printedcircuitbeans/RP2040-SM-PCB/CAD FILES/readme.txt

CAD FILES for the RP2040 based smartwatch:
