printedcircuitbeans/RP2040-SM-PCB/Alitum Exports/FAB-RP2040 DEV SW FINAL-A.2/Report Board Stack/DEV-NEAT-FINAL.xls

Board Stack Report
Stack Up |  | Layer Stack
Layer | Board Layer Stack | Name | Material | Thickness | Constant
1 |  | Top Paste
2 |  | Top Overlay
3 |  | Top Solder | Solder Resist | 0.40mil | 3.5
4 |  | Top Layer | Copper | 1.38mil
5 |  | Dielectric 3 | 7628*1 | 8.28mil | 4.1
6 |  | Layer 2 | Copper | 0.60mil
7 |  | Dielectric 4 | Core-009 | 41.93mil | 4.5
8 |  | Layer 1 | Copper | 0.60mil
9 |  | Dielectric 1 | 7628*1 | 8.28mil | 4.8
10 |  | Bottom Layer | Copper | 1.38mil
11 |  | Bottom Solder | Solder Resist | 0.40mil | 3.5
12 |  | Bottom Overlay
13 |  | Bottom Paste
 | Height : 63.25mil
