printedcircuitbeans/RP2040-SM-PCB/DATASHEETS/H424a9c0b000a45a7a4c9680e89fcf62a3.webp

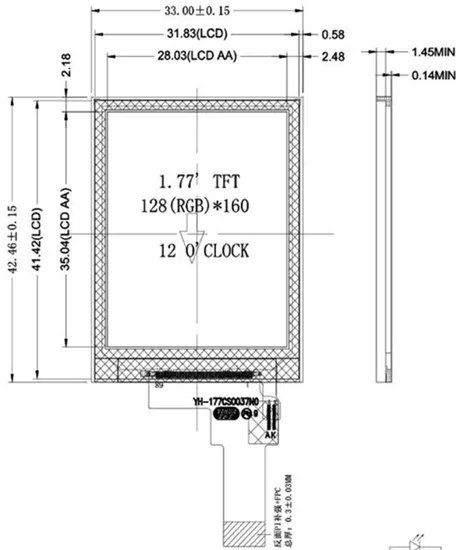
DATASHEETS/H424a9c0b000a45a7a4c9680e89fcf62a3.webp
