printedcircuitbeans/RP2040-SM-PCB/Alitum Exports/PCBA-RP2040 DEV SW FINAL-[NO VARIATIONS]-A.2/BOM/BOM_PartType-RP2040 DEV SW FINAL.xlsx

Comment | Description | Designator | Footprint | LibRef | Quantity
Renesas DA14531-00000FX2 | Bluetooth 5.1 SoC ARM Cortex-M0+ 16MHz Single Core 1.1V to 3.3V SMD 148-Pin HVQFN | *1 | Renesas DA14531-00000FX2-Footprint-1 | CMP-129872772-4 | 1
Maxim Integrated MAX30100EFD+T | Pulse Oximeter and Heart-Rate Sensor IC 14-Pin OLGA T/R | *2 | Maxim Integrated MAX30100EFD+T-Footprint-1 | CMP-50cf9b13ca238f08-2 | 1
STMicroelectronics IIS2MDCTR | IIS2MDC Series 3.6 V Ultra-Low-Power 3-axis Digital Magnetic Sensor - LGA-12 | *3 | LGA-12 2.0 x 2.0 x 0.7 mm | CMP-a578694f2da77abf-3 | 1
InvenSense MPU-6050A | Analog Circuit, 1 Func, CMOS | *4 | PCB-1172158-1 | CMP-a17e6d5fd3637eb9-1 | 1
Samsung CL05B104KP5NNNC | CL05 Series 0.1 uF 10 V ±10 % Tolerance X7R SMT Multilayer Ceramic Capacitor | C1, C2, C3, C4, C5, C6, C7, C8, C9, C11, C12, C20, C28, C29 | PCB-wdo14ufqtx9e5lciolxc-1 | CMP-97145e617dc648d3-3 | 14
Samsung CL05A105KO5NNNC | CL05 Series 1 uF 16 V ±10 % Tolerance X5R SMT Multilayer Ceramic Capacitor | C10, C13, C18, C19, C24, C26, C27, C31, C32, C35, C36, C40 | Samsung CL05A105KO5NNNC-Footprint-1 | CMP-a18e680969d57e49-13 | 12
Murata GJM1555C1H150FB01D | Cap, 15p, C0G, 1%, 50V, 0402 | C14, C15 | PCB-4vt9n1dcietv35vzc4o1-1 | CMP-3570434-3 | 2
Murata GJM1555C1H1R8WB01D | Multilayer Ceramic Capacitors MLCC - SMD/SMT 0402 1.8pF 50Volts C0G +/-0.05pF | C16, C17 | CAPC1005X55X25LL05T10 | CMP-3552358-2 | 2
TDK C1608X5R1C475K080AC | Eia Case Size: 0603, Voltage: 16, Cap Value: 4700000, Tol: +/-10%, Thickness: 0.80 ± 0.10 | C21, C22, C23, C37 | 1608(0603) IPC CAP | CMP-77fabf7cbdb2a83d-7 | 4
Samsung CL10A106MQ8NNNC | Ceramic capacitor SMD-0603 10uF /6.3V X5R# M +-20%, Samsung, RoHS | C25 | PCB-2sbl9jnrnicgpdohsx1t-1 | CMP-093fc04ae399d6f8-2 | 1
AVX Interconnect / Elco 0603ZC224JAT2A | CAP CER 0.22UF 10V 5% X7R 0603 | C30 | CAPC1608X90X35NL15T15 | CMP-130958-3 | 1
Vitramon VJ0603Y103KXAPW1BC | Multilayer Ceramic Capacitors MLCC - SMD/SMT 0603 0.01uF 50volts X7R 10% | C33 | CAPC1608X95X40NL15T15 | CMP-3553671-2 | 1
Murata GRM1885C1H222JA01D | 0603 2.2 nF 50 V ±5% Tolerance C0G SMT Multilayer Ceramic Capacitor | C34 | PCB-8dymt4l4b369ba09ow0n-1 | CMP-dffd16f504ca003a-2 | 1
AVX 06036D106MAT2A | 0603 10 uF 6.3 V ±20 % Tolerance X5R Surface Mount Multilayer Ceramic Capacitor | C38 | CAPC1608X90X35LL15T15 | CMP-127006-7 | 1
0.01 uF 0402 X7R capacitor | 0.01 uF 0402 X7R capacitor | C39 | CAPC1005X55X25LL05T05 | CMP-3553635-7 | 1
Molex 73412-0114 | RF / Coaxial Connector, Coaxial, Straight Jack, Surface Mount Vertical, 50 ohm, Brass | CON1, CON2 | PCB-6g8ee53o8kk4vespa54x-1 | CMP-db4512efd04e0482-2 | 2
Vishay VLMG1500-GS08 | LED Uni-Color Yellow Green 574nm 2-Pin Chip 0402(1006Metric) T/R | D1 | PCB-w8p5vpt5ck0v4tv1c0z3-1 | CMP-709bb8fee08eaf5c-2 | 1
TE Connectivity CRGP0603F10K | Res Pulse Withstand Thick Film 0603 10k Ohm 1% 1/4W ±100ppm/°C Molded Paper T/R | DNF1 | RESC1609X50X30ML10T20 | CMP-518d9deba10a8e4a-1 | 1
Texas Instruments BQ29707DSET | Li-Ion/Li Polymer Advanced Single-Cell Battery Protector IC Family 6-WSON -40 to 85 | IC1 | PCB-g2sx667f610inbgayesa-1 | CMP-4d0d86cbeaee92ca-1 | 1
Würth Elektronik 693072010801 | WR-CRD Micro SD Card Connector, Hinge Type | J1 | PCB-do3jp31eh8pi4jp1qrj0-1 | CMP-fef136a731692136-4 | 1
Würth Elektronik 68712414522 | FFC / FPC Board Connector, Right Angle, Surface Mount, Receptacle, 24, Top, 0.5 mm | J2 | PCB-a5ulz59vuszfit0rje83-1 | CMP-d08318d21a710f44-6 | 1
Global Connector Technology USB4105-GF-A Reversible | Conn USB 2.0 Type C RCP 16 POS 0.3mm/0.5mm Solder RA SMD 16 Terminal 1 Port T/R | J3 | PCB-jtoj50qxusyca8vax1pa-1 | CMP-02a6cdcbf5c5dd61-16 | 1
Murata LQP03TN3N3B02 | Fixed Ind 3.3NH 450MA 250 Mohm | L1 | CAPC0603X33X15NL03T05 | CMP-68076667-1 | 1
Murata LQG15HN27NJ02D | Inductor RF Chip Unshielded Multi-Layer 27nH 5% 100MHz 8Q-Factor Ceramic 300mA 670mOhm DCR 0402 T/R | L2 | PCB-rkasoom3n033do6ysrzd-1 | CMP-af81668e63ad7046-2 | 1
Taiwan Semiconductor TSM320N03CX RFG | Trans Mosfet N-ch 30V 4A 3-PIN SOT-23 T/r | Q1 | PCB-o1p2u0wd1kv0akxl2dnz-1 | CMP-f47a39300fc92bbd-1 | 1
Diodes Inc. DMS2085LSD-13 | Trans MOSFET P-CH 20V 3.3A Automotive 8-Pin SO T/R | Q2 | PCB-u540y1ba36l7q4ljo86i-1 | CMP-469b8d639ac3995c-1 | 1
CSD16406Q3 | the nexfet power mosfet has been designed to minimize losses in power conversion applications. | Q3, Q4 | PCB-fjclzc86ay25m1aekmjs-1 | CMP-4f7f86ea0b4d90b8-3 | 2
Vishay Dale TNPW04021K00BEED | Thin Film Resistors - SMD 1Kohms .1% 25ppm | R1, R2, R19 | RESC1005X40X20NL05T10 | CMP-1862936-2 | 3
Panasonic ERJ-2RKF1004X | Res Thick Film 0402 1M Ohm 1% 1/10W ±100ppm/°C Molded SMD Punched Carrier T/R | R3, R4 | Panasonic ERJ-2RKF1004X-Footprint-1 | CMP-3655675-6 | 2
Panasonic / Panasonic ECG ERJ-2RKF1003X | Resistor Thick Film 0402 100k Ohm 1% 1-10 Watt ±100ppm °C Surface Mount Punched Carrier Tape and Reel | R5, R6, R7, R8, R9, R12, R13, R17, R20 | PCB-8tuutlkq7p1aj3t2dfdp-1 | CMP-3656264-9 | 9
Panasonic ERJPA3F22R0V | PANASONIC ERJPA3F22R0V RESISTOR, ERJP, 22 OHM, 0603, 0.25W, 1% | R10 | PCB-12519960-1 | CMP-12519960-2 | 1
Yageo RC0402FR-0710KP | Res Thick Film 0402 10K Ohm 1% 0.063W(1/16W) ?150ppm/C Epoxy SMD T/R | R11, R23 | PCB-ailbuo3ywjkw9fqo6ae9-1 | CMP-ab0360df1e7174c4-1 | 2
Panasonic ERA-3AEB331V | Res Thin Film 0603 330 Ohm 0.1% 1/10W ±25ppm/°C Molded SMD SMD Punched Carrier T/R | R14 | PCB-8r88lubijgs0c6mgtabl-1 | CMP-4ace83d64f829509-1 | 1
Yageo AC0402FR-075K1L | 0402 5.1k ohms 1% automotive grade chip resistor | R15, R18 | RESC1005X37X25NL05T10 | CMP-9589553-2 | 2
Ohmite HVC0603T5004FET | Res, Thick Film, 5m, 1%, 0.1w, 0603, Reel | R16, R22 | CAPC1608X90X35ML10T15 | CMP-d904124280fd06c3-2 | 2
CRGCQ0603J2K2 | Res, AEC-Q200, Thick Film, 2K2, 5%, 0603 | R21 | PCB-2t5lv6a742zfbi3344hk-1 | CMP-ce770211389311b0-1 | 1
Yageo / Phycomp RC0402FR-0727R4L | Thick Film Resistors 27.4 OHM 1% | R24, R25 | RESC1005X40X25ML05T10 | CMP-3759239-2 | 2
TE Connectivity CRGCQ0402J4K7 | Res, Aec-Q200, Thick Film, 4K7, 5%, 0402 | R26, R27, R28 | PCB-14dubun49lr56ezfiiqx-1 | CMP-86884aee70c6594f-2 | 3
CRGP0603F10R | Res Thick Film 0603 10 Ohm 1% 0.25W(1/4W) ±100ppm/°C Pad SMD Automotive T/R | R29 | R0603_A | CMP-9edf52b96e5b4118-1 | 1
Würth Elektronik 436331045822 | SWITCH, 220GF, SIDE, BLK, SMD, BOSS; Contact Configuration: DPST; Operating Force: 220N; Contact Voltage DC Nom: 12V;... | S1, S2, S3, S4, S5 | PCB-9flvzoe0mjj29e3x6sbq-1 | CMP-c24e0a183ce31d89-1 | 5
Panasonic ERTJ1VG103FA | Thermistor NTC 10K Ohm 1% 2-Pin 0603 Surface Mount Solder Pad 3435K Paper T/R | T1 | RESC1608X90X30ML15T20 | CMP-2b8ee208eb7af449-1 | 1
Winbond W25Q16JVUXIQ | 16Mb Serial NOR Flash 133MHz USON8 | U1 | Winbond W25Q16JVUXIM TR-Footprint-1 | CMP-467c8a66a27f99bb-1 | 1
u-blox MAX-M10S-00B | MAX-M10 Series 3.6 V 167 dBm Surface Mount Standard Precision GNSS Module | U2 | PCB-005urkm0n3ublf78fa9k-1 | CMP-560f9853949789c8-2 | 1
RP2040 | Raspberry Pi , Mcu, 32 Bit, 133MHZ, QFN-56; | U3 | RP2040-Footprint-1 | CMP-0073ce6d2ab8dfb4-11 | 1
TC1185-3.3VCT713 | 50 mA, 100 mA and 150 mA CMOS LDOs with Active-Low Shutdown and Reference Bypass, 5-Pin SOT-23, Extended Temperature, Tape and Reel | U4, U8 | SOT-23-CT5_N | CMP-1493173-2 | 2
MCP73837-FCI/MF | Stand-Alone Li-Ion/Li-Polymer Battery Charge Management Controller with Autonomous AC-Adapter or USB-Port Source Selection, 4.2V, 10-Pin DFN, Industrial Temperature | U5 | DFN-MF10 | CMP-961403-2 | 1
Bosch Tools BME680 | BME680 Series 3.6 V 3.1 µA Low Power Gas Pressure Temperature humidity Sensor | U6 | PCB-909kwbqua9921xjxq73y-1 | CMP-8bd947d89053541e-2 | 1
LD39015M18R | 150 mA Low Quiescent Current Low Noise Voltage Regulator, 1.8V, 5-Pin SOT-23, Tape and Reel | U7 | SOT23-5L_N | CMP-1494047-2 | 1
Abracon ABM3C-12.000MHZ-D4Y-T | Crystal 12MHz Â±30ppm (Tol) Â±30ppm (Stability) 18pF FUND 60Ohm Automotive 4-Pin CSMD T/R | X1 | PCB-uqcmlcvakm867rdp8al8-1 | CMP-55e09ddaa6fe8a27-2 | 1
Murata XRCGB32M000F1H00R0 | Crystal 32.0000mhz 6pf Smd | X2 | PCB-j1edtquohpspoyruottx-1 | CMP-7e03b3e81033a1c4-2 | 1
