printedcircuitbeans/RP2040-SM-PCB/DOCUMENTATION/Main Schematic B&W.pdf

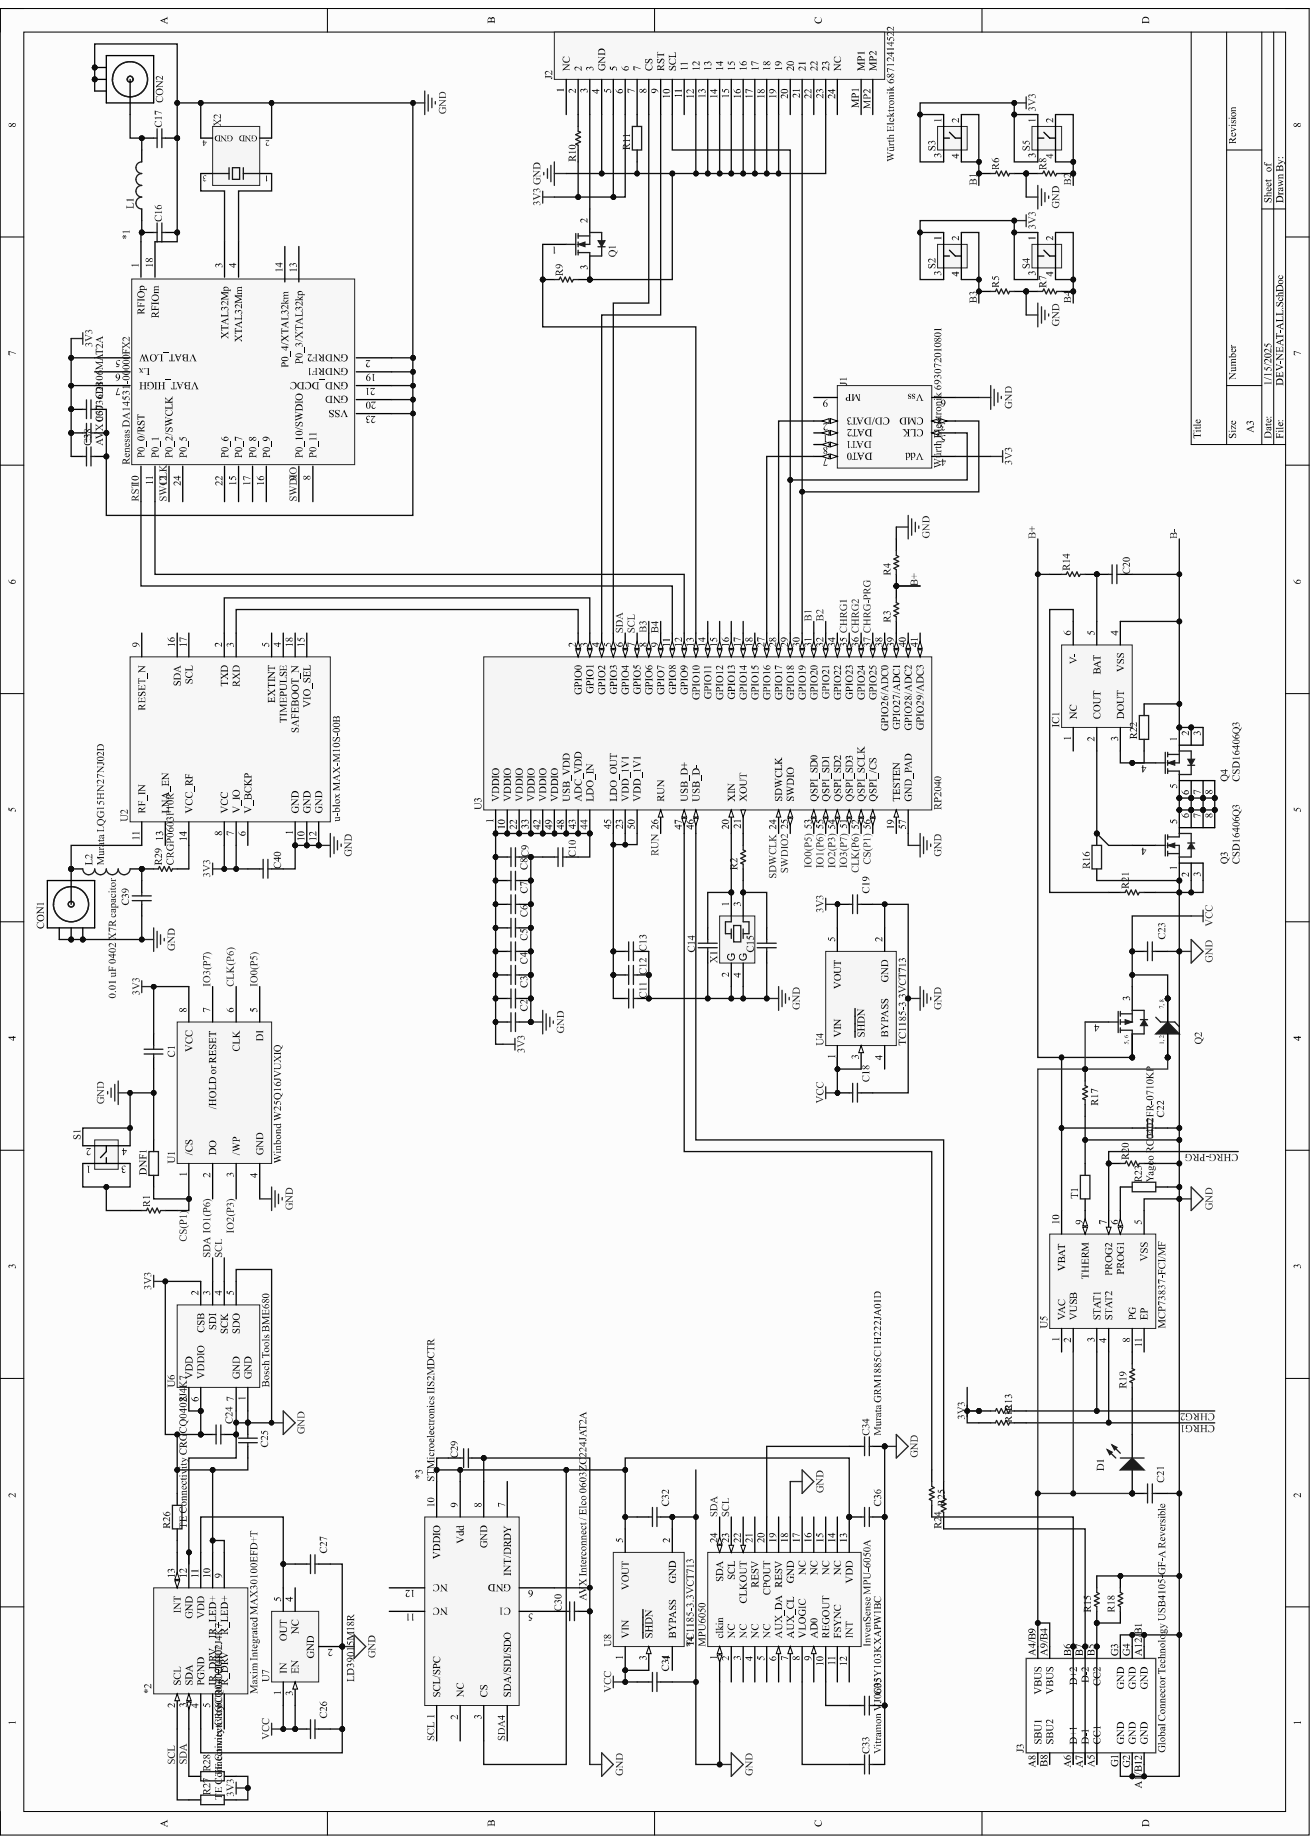
[picture p2: page 1]
