printedcircuitbeans/RP2040-SM-PCB/Alitum Exports/FAB-RP2040 DEV SW FINAL-A.2/Fabrication.PDF

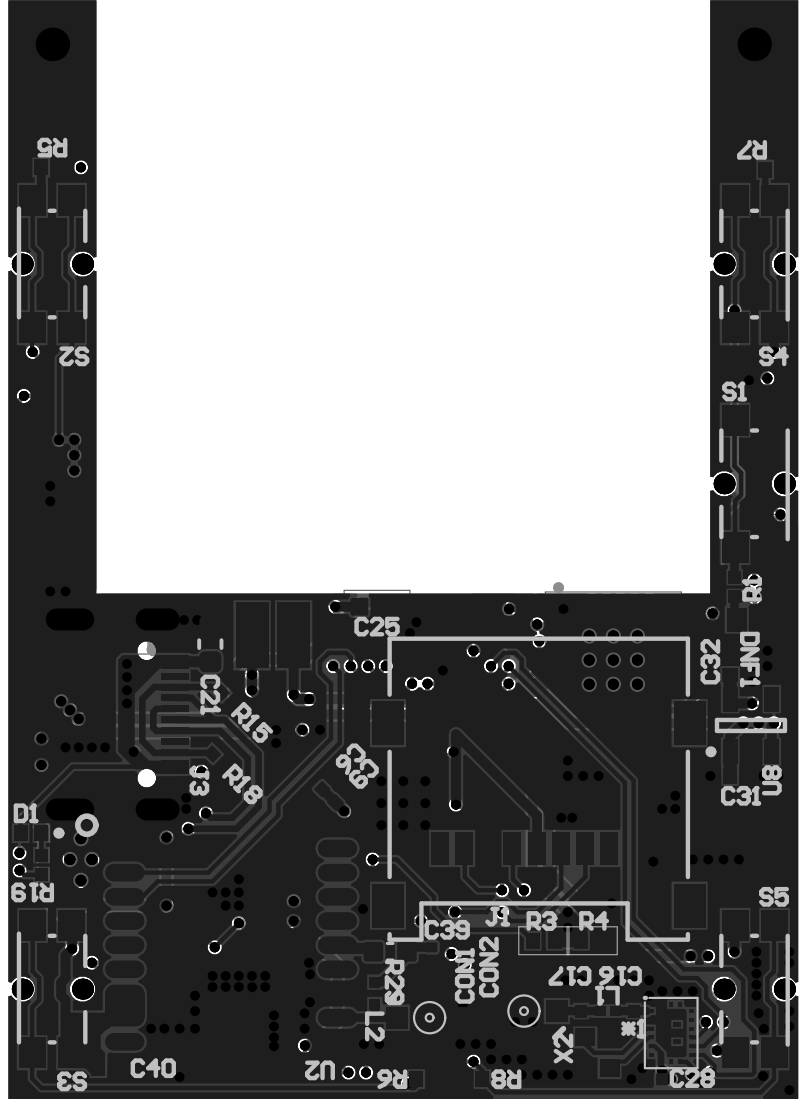
[picture p3: page 1]
