printedcircuitbeans/RP2040-SM-PCB/(commit log)

2024-12-01 Create Board changelog
2024-12-01 Update Board changelog
2025-01-15 Added updated BOM with all correct part numbers
    [20250115_rp2040_dev_sw_final_xlsx.csv]
2025-02-14 Update WATCHBasic01.ino
    -Added a proper on / off system using button delays
    -Started framework for MAX30100
    -Some UI framework
2025-02-26 Update WATCHBasic01.ino
    Added dynamically resizing GPS ui
    some debugging lead to modifcation of data fetching from the gps, as well as a "cleaner" pipeline : less uneccesary operations.
    Chip clocked reduced from 133mhz to 50mhz for lower power consumption.
    -> Started testing IIS2MDCTR and BME680 - data good for IIS2MDCTR, BME680 needs extensive calibration.
2026-01-02 Added CAD exports
    [BOM_PartType-RP2040 DEV SW FINAL.xlsx, DEV-NEAT-FINAL.xls]
2026-02-26 Moved files to new folders
    [20250115_rp2040_dev_sw_final_xlsx.csv]
2026-03-01 Enhance project description with sensor and storage details
    Expanded the description of the project to include details about sensor selection and storage options.
2026-04-08 Start migrating os from Arduino IDE to VSCODE - Screen (library) setup and basic deep sleep done
2026-05-06 Enhance README with additional project details
    Expanded on the RP2040 microcontroller's capabilities and added details about the Bluetooth connectivity and sensor choices for the smartwatch project.
